WindsorHSRobotics/2021_Rocket_Lab/README.md

# 2021 Rocket Lab 🚀

![Windsor High School sophomore Alex Oakley, in black shirt and jeans, launches her rocket during a rocket launch project involving the Robotics Engineering and AP Physics classes at Windsor High School in Windsor Oct. 5, 2021. The project, a collaboration with the University of Colorado Ann and H.J. Smead Aerospace Engineering Sciences department, had students in the Robotics Engineering class build electronic modules to record barometric pressure data and assemble them into the rockets’ nose cones to collect data for analysis by the AP Physics students. (Alex McIntyre/Staff Photographer)](https://www.greeleytribune.com/wp-content/uploads/2021/10/GRE-L-WindsorHSRockets-AM0726.jpg?w=1196)

This lab is a collaboration between the Windsor High School (Colorado) AP Physics and Robotics Engineering classes.  The lab was written by [Matt Rhode](https://www.colorado.edu/aerospace/matt-rhode) at the University of Colorado in Boulder.  Students in Mr. Ash's AP Physics class predict height of rocket launches based on thrust and weight.  Students in Mr. Cline's Robotics Engineering class build the electronics systems and program the Arduino NANO microcontrollers to record altitude data for the flights.  All flights will take place at Windsor High School on October 4th, 2021.

## Materials

- [Arduino NANO with USB Cable Type A Male to Micro Type B Male](https://store-usa.arduino.cc/products/arduino-nano?selectedStore=us)
- [SparkFun OpenLog](https://www.sparkfun.com/products/13712)
- [8 GB Micro SD Card](https://www.amazon.com/Gigastone-2-Pack-Surveillance-Security-Professional/dp/B0858FBL8V/ref=sr_1_4?dchild=1)
- [Barometric Pressure Sensor](https://www.amazon.com/Sipytoph-Precision-Atmospheric-Pressure-Barometric/dp/B092MSFPMX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)
- [Stacking Pin Headers](https://www.amazon.com/2-54mm-Straight-Connector-Assortment-Arduino/dp/B0785SP8PB/ref=sr_1_2?dchild=1)
- 5mm LED
- 330 Ohm resistor

## References

[Greeley Tribune Article from October 2021](https://www.greeleytribune.com/2021/10/05/blast-off-windsor-high-students-team-up-to-build-and-launch-rockets/)
