WindsorHSRobotics/2021_Rocket_Lab/Configuring the Arduino Web Editor on a Chromebook.md

# Configuring the Arduino Web Editor on a Chromebook

### The scripts used in this project may be uploaded to the NANO with the correct configuration.  Follow the steps below to set everything up:

1. Sign up for an Arduino Create account [here](https://login.arduino.cc/) if you do not already have one.
2. Add the Arduino Create for Education App to your Chromebook by clicking on this [link](https://chrome.google.com/webstore/detail/arduino-create-for-educat/elmgohdonjdampbcgefphnlchgocpaij) and selecting "Add to Chrome".
3. Copy the code found in this repository in the file titile [Nano_barometric_sensor.ino](https://github.com/WindsorHSRobotics/2021_Rocket_Lab/blob/main/Sketches/NANO_Barometric_Sensor.ino) into the code window.
4. Save the file to your Arduino Create account.
5. Connect the NANO to the Chromebook via the USB cable.
6. At the top select this pulldown to choose the port and board and click "Select Other Board and Port".



8. Select **Arduino Nano** under board and **ATmega328P (Old Bootloader)** for the Flavour.

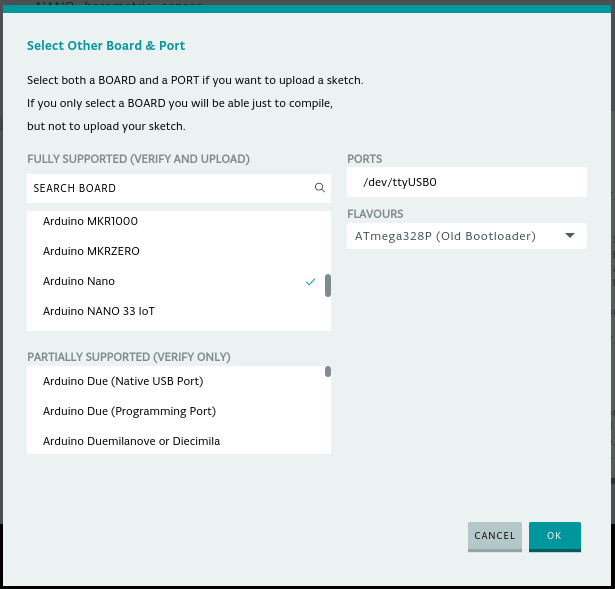
[picture p1: Images/Screenshot 2021-09-22 2.14.32 PM.png]


10. Click "Upload" (the right arrow).

### You should be all set to use the NANO with your Chromebook! 	:rocket:
