WindsorHSRobotics/2021_Rocket_Lab/Images/Figure_2.2.jpg

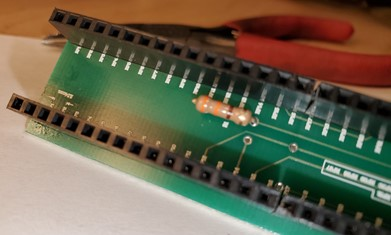
Images/Figure_2.2.jpg
