WindsorHSRobotics/2021_Rocket_Lab/Images/Figure_2.3.jpg

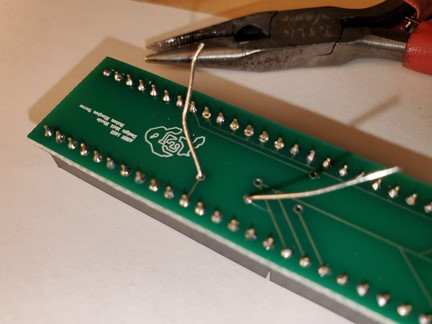
Images/Figure_2.3.jpg
