WindsorHSRobotics/2021_Rocket_Lab/3D_prints/ballast.STL

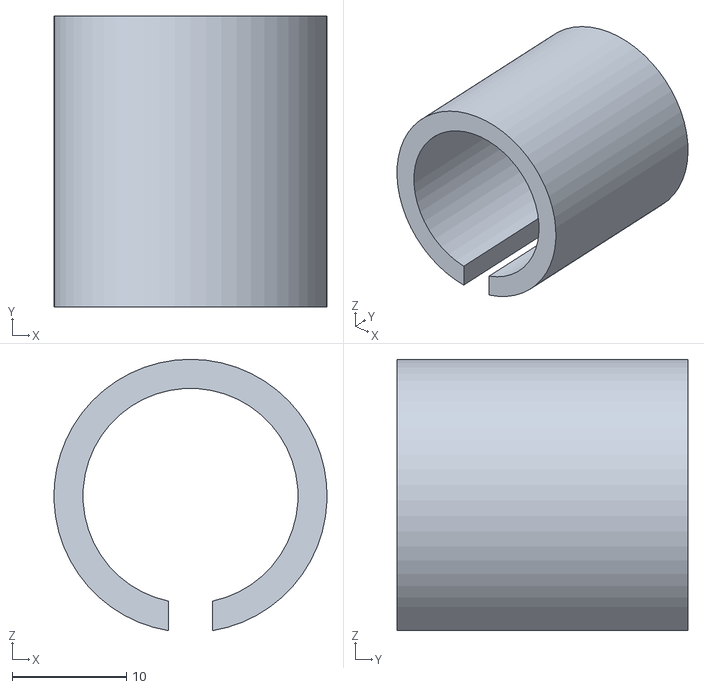
[picture p5: CAD file, 2021-10-09]
3D_prints/ballast.STL
23.9 x 25.4 x 23.7
