WindsorHSRobotics/2021_Rocket_Lab/3D_prints/rocket nose adapter with battery housing.STL

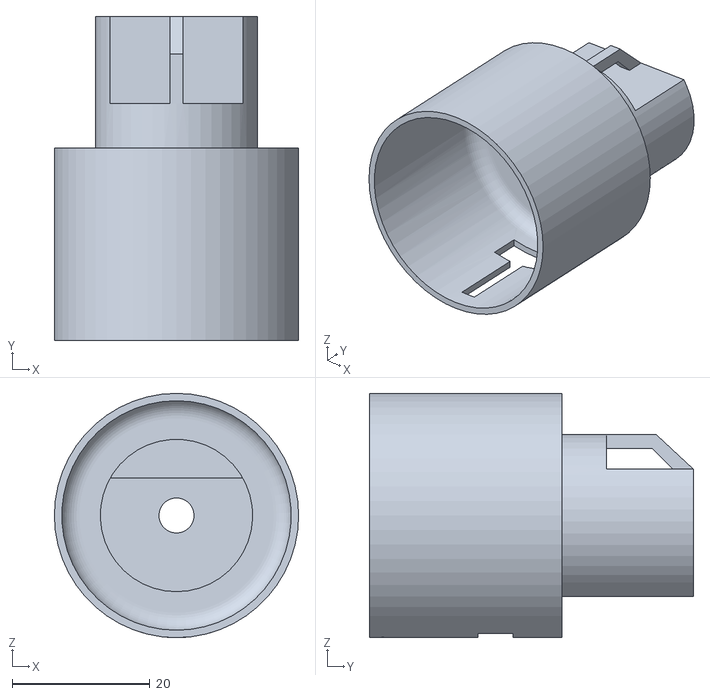
[picture p6: CAD file, 2021-10-09]
3D_prints/rocket nose adapter with battery housing.STL
35.4 x 47.0 x 35.4
