WindsorHSRobotics/2021_Rocket_Lab/3D_prints/rocket nose for battery housing.STL

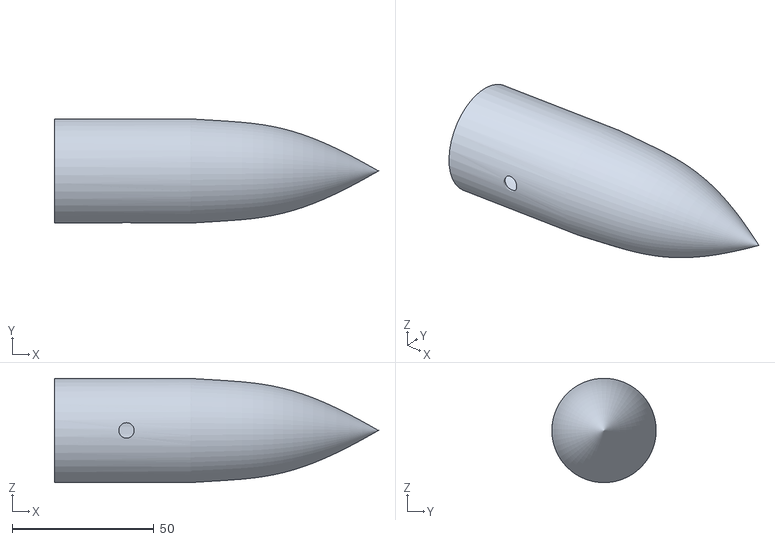
[picture p7: CAD file, 2021-10-09]
3D_prints/rocket nose for battery housing.STL
114.3 x 36.8 x 36.8
