WindsorHSRobotics/2021_Rocket_Lab/3D_prints/ballast washers part ii.STL

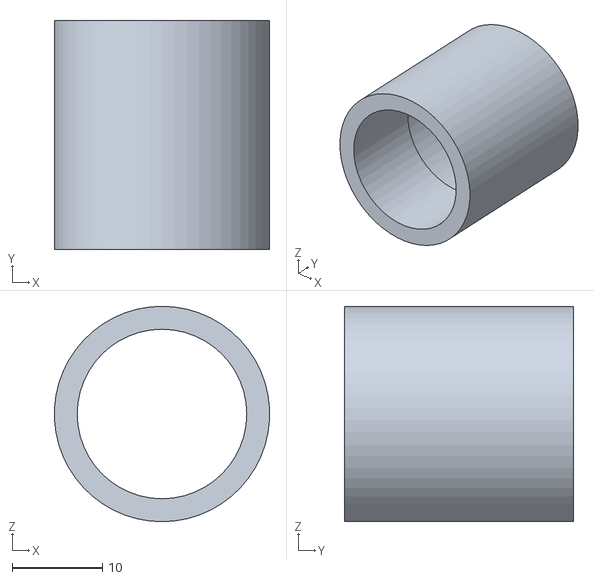
[picture p8: CAD file, 2021-10-09]
3D_prints/ballast washers part ii.STL
23.8 x 25.4 x 23.9
