WindsorHSRobotics/2021_Rocket_Lab/3D_prints/README.md

Use these files to replace the rocket nose cone.  The electronics will fit in this cone.  Ballast also needs to be added near the engine.
