WindsorHSRobotics/2021_Rocket_Lab/Results/README.md

## Results of the Launch Day

### Data collected may be found in the folders linked below.  The raw data is in csv format but is converted to a spreadsheet with an accompanying chart.

[Log Files](https://drive.google.com/drive/folders/1Sr_nlI2fNqkegYeys4EfAYwXzlu-X6Fs?usp=sharing)

[Student Processed Data](https://drive.google.com/drive/folders/1EKLnKKymHw3ojfhuQn9KZmwB-uFCtaMt?usp=sharing)

Below is an example of one of the rocket results

Height (m) vs Time (s)
