WindsorHSRobotics/2021_Rocket_Lab/(commit log)

2021-09-22 Create Configuring the Arduino Web Editor on a Chromebook.md
2021-09-22 Update Configuring the Arduino Web Editor on a Chromebook.md
2021-09-23 Update and rename Arduino_NANO_Shield_Build_Instructions.md to Arduino NANO Barometric Pressure Sensor Build Instructions.md
